CMU-Robotics-Club/QBot/3D Printer Design/MDR-M7 Individual STL/MDR-M7-MotoG.JPG

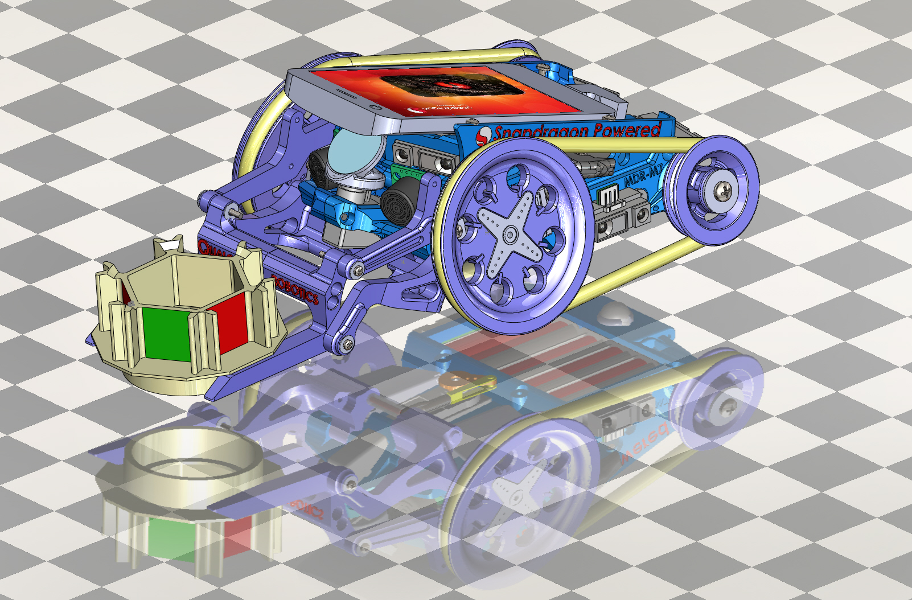
3D Printer Design/MDR-M7 Individual STL/MDR-M7-MotoG.JPG
