CMU-Robotics-Club/QBot/3D Printer Design/MDR-M7 Body STL/MDR-M7-BodyParts.JPG

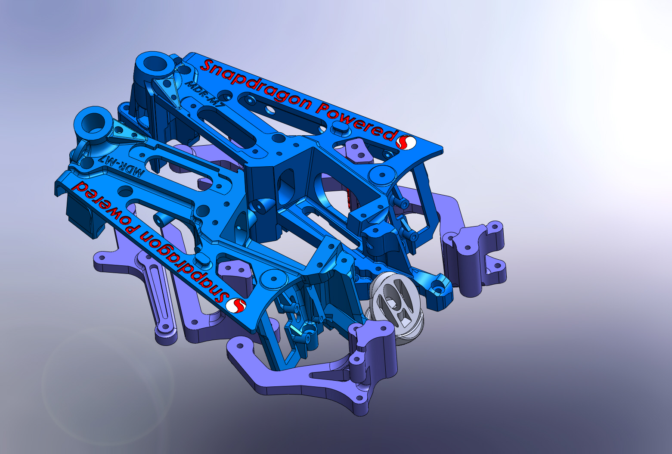
3D Printer Design/MDR-M7 Body STL/MDR-M7-BodyParts.JPG
