CMU-Robotics-Club/QBot/README.md

QBot
====

Experiments with a Qualcomm designed robot platform. 

Documentation https://www.qualcomm.com/invention/research/projects/robotics/micro-rover

Bluetooth Pass: 4545
