CMU-Robotics-Club/QBot/3D Printer Design/QBotBOM.xlsx

 | Snapdragon Bot Bill of Materials | Number of Teams | 6
Received | Part | Quantity | Overall Quantity | Source | Link | Approx Price | Total Price | Notes
yes | 1-INCH DIAMETER MIRROR | 1 | 6 | amazon | http://www.amazon.com/1-IN-ROUND-MIRROR- 25PC-PKG/dp/B0018N66YC (http://www.amazon.com/1-IN-ROUND-MIRROR-%2025PC-PKG/dp/B0018N66YC) | $8.24 | $8.24 | 25 piece set
 | 4-PIN RIGHT ANGLE HEADER, 0.100-INCH SPACINGND/314229 | 1 | 6 | digikey | http://www.digikey.com/product-detail/en/0022288243/WM50026-24-ND/314229 | $1.53 | $9.18
 | 2X4 STRAIGHT HEADER, 0.100-INCH SPACING | 1 | 6 | digikey | http://www.digikey.com/product-search/en?vendor=0&keywords=67997-210HLF | $0.42 | $2.52
 | 2-PIN RIGHT ANGLE HEADER, 0.100-INCH SPACING | 1 | 6 | digikey | http://www.digikey.com/product-search/en?vendor=0&keywords=0901220125 | $1.39 | $8.34
 | IOIO-OTG | 1 | 6 | diygadget | http://www.diygadget.com/ | $25.00 | $150.00 | This package comes with a bluetooth dongle
 | TURNIGY TG9 SERVO | 1 | 6 | hobbyking | http://hobbyking.com/hobbyking/store/__42420__ Turnigy_TG9_9g_1_7kg_0_12sec_Eco_Micro_Servo_ USA_warehouse_.html | $2.60 | $15.60
 | Makerbot Replicator Blue ABS Filament | 2 | 2 | makerbot | https://store.makerbot.com/abs-filament | $48.00 | $96.00 | Get 1 purple and 1 red
 | 112-MM LENGTH, 6-MM DIAMETER O-RING | 2 | 12 | marshallshardware | http://www.marshallshardware.com/products/product.aspx?pid=26886&kw=6112&st=0 | $2.70 | $32.40
 | #10 X 3/4 X 0.040-INCH FLAT NYLON WASHER | 2 | 12 | marshallshardware | http://www.marshallshardware.com/products/product.aspx?pid=11344&kw=NYLON%20washer&st=0 | $0.10 | $1.20
 | M2.5 PAN HEAD MACHINE SCREW, 6-MM LENGTH | 13 | 78 | marshallshardware | http://www.marshallshardware.com/products/product.aspx?pid=2-52-733-158-9497&lid=1 | $0.05 | $3.90
 | #8 X 3/8 X 1-INCH NYLON SPACER | 2 | 12 | marshallshardware | http://www.marshallshardware.com/products/product.aspx?pid=14290&lid=1%20%20%20% 20%20%20%20%20%20%20%20%20%20%20%20%20&kw=0511107&st=0 | $0.19 | $2.28
yes | 2-56 X 7/8-INCH PAN HEAD MACHINE SCREW | 6 | 36 | mcmaster | http://www.mcmaster.com/#91772a085/=sda7o1 | $4.66 | $4.66 | Packs of 100
yes | 2-56 HEX NUT | 6 | 36 | mcmaster | http://www.mcmaster.com/#90760a009/=sjt7h4 | $3.11 | $3.11 | Packs of 100
yes | 4-40 SOCKET HEAD MACHINE SCREW, 1 ½-INCH LENGTH | 2 | 12 | mcmaster | http://www.mcmaster.com/#91251a149/=sd9q3y | $11.48 | $11.48 | Packs of 50
yes | #8 3/8-INCH FLAT NYLON SPACER, LENGTH 1 1/8-INCH LENGTH | 2 | 12 | mcmaster | http://www.mcmaster.com/#94639a068/=sjs9om | $7.33 | $21.99 | Packs of 5
yes | MUSIC WIRE, 0.078-INCH DIAMETER, 1.40-INCH LENGTH | 1 | 1 | mcmaster | http://www.mcmaster.com/#8890k122/=su430w | $2.17 | $2.17 | 3 foot rod
yes | 4-40 NYLON SCREW, ½-INCH LENGTH | 4 | 24 | mcmaster | http://www.mcmaster.com/#93135a276/=sjtpg7 | $5.25 | $5.25 | Pack of 100
yes | #2 FLAT WASHER | 10 | 60 | mcmaster | http://www.mcmaster.com/#90126a501/=sda9xs | $1.48 | $1.48 | Pack of 100
yes | 4-40 SOCKET HEAD MACHINE SCREW, 1-INCH LENGTH | 2 | 12 | mcmaster | http://www.mcmaster.com/#91251a115/=sd9pat | $5.31 | $5.31 | Pack of 50
yes | 8-32 PAN HEAD MACHINE SCREW, 1.625-INCH LENGTH | 2 | 12 | mcmaster | http://www.mcmaster.com/#91772a204/=sjs8kq | $7.68 | $7.68 | Pack of 50
yes | 18-8 THREAD FORMING SCREW, 1-32 THREAD, ¼-INCH LENGTH | 8 | 48 | mcmaster | http://www.mcmaster.com/#99461a615/=sjtall | $11.45 | $11.45 | Pack of 50
yes | 4-40 FLAT HEAD MACHINE SCREW, ¾-INCH LENGTH | 1 | 6 | mcmaster | http://www.mcmaster.com/#91771a113/=ske8x2 | $5.42 | $5.42 | Pack of 100
 | Moto G | 1 | 6 | new egg | http://www.newegg.com/Product/Product.aspx?Item=N82E16875209391 | $100.00 | $600.00 | Galexy S3/S4 works too
 | AR-3606HB ROBOT SERVO | 2 | 12 | pololu | http://www.pololu.com/product/2149/pictures | $15.00 | $180.00
 | HD-3001HB ANALOG SERVO | 1 | 6 | pololu | http://www.pololu.com/product/1058 | $10.00 | $60.00
 | 2-BATTERY BAY | 1 | 6 | pololu | http://www.pololu.com/product/1150 | $0.70 | $4.20
 | 3-PIN TOGGLE SWITCH | 1 | 6 | pololu | http://www.pololu.com/product/1407 | $1.75 | $10.50
 | 3-BATTERY BAY | 1 | 6 | pololu | http://www.pololu.com/product/142 | $1.00 | $6.00
 |  |  |  |  |  |  | $1270.36
