CMU-Robotics-Club/QBot/3D Printer Design/MDR-M7 Wheels STL/MDR-M7-WheelParts.JPG

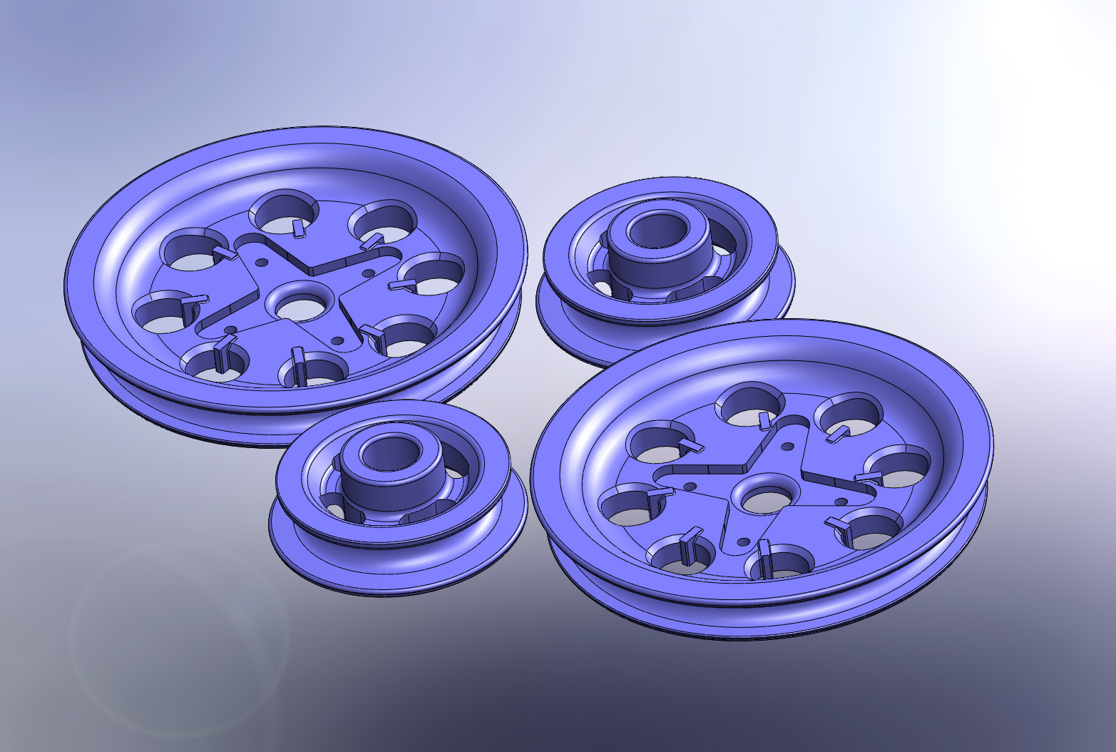
3D Printer Design/MDR-M7 Wheels STL/MDR-M7-WheelParts.JPG
