CMU-Robotics-Club/QBot/3D Printer Design/MDR-M7 CAD IGES/IFC6410CamMnt7.IGS

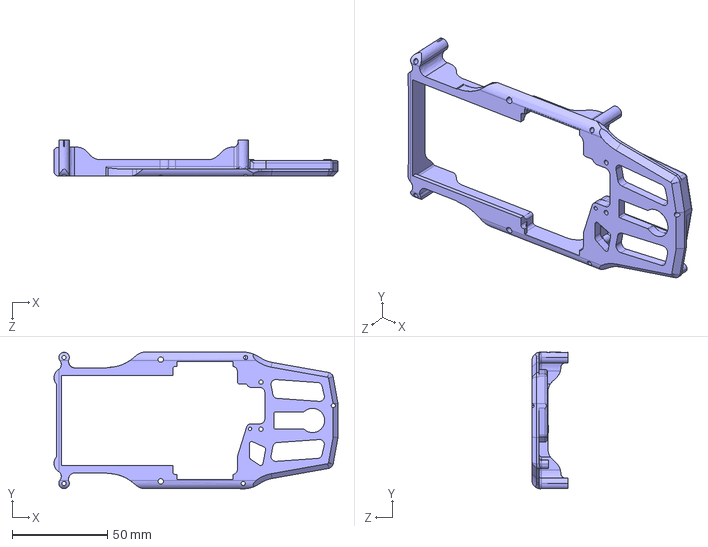
[picture p4: CAD file, 2014-09-16]
3D Printer Design/MDR-M7 CAD IGES/IFC6410CamMnt7.IGS
149.1 x 71.7 x 19.1 mm
