CMU-Robotics-Club/QBot/3D Printer Design/MDR-M7 Individual STL/MDR-M7-WheelParts - MDR-FrontWheel-1.STL

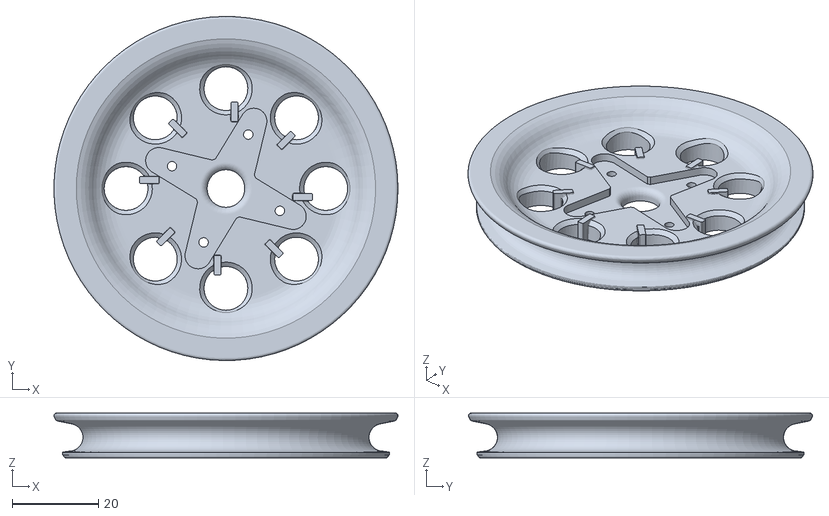
[picture p5: CAD file, 2014-09-16]
3D Printer Design/MDR-M7 Individual STL/MDR-M7-WheelParts - MDR-FrontWheel-1.STL
79.8 x 79.8 x 10.4
