CMU-Robotics-Club/QBot/3D Printer Design/MDR-M7 Individual STL/MDR-M7-BodyParts - MDR-RightUpperForkLiftArm-1.STL

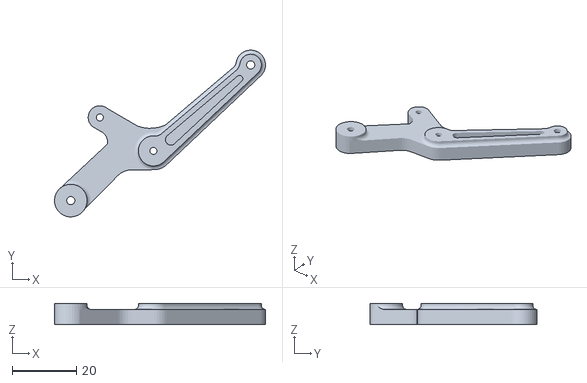
[picture p6: CAD file, 2014-09-16]
3D Printer Design/MDR-M7 Individual STL/MDR-M7-BodyParts - MDR-RightUpperForkLiftArm-1.STL
65.5 x 51.7 x 6.67
