CMU-Robotics-Club/QBot/3D Printer Design/MDR-M7 Individual STL/MDR-M7-BodyParts - MDR-RightForkLift-1.STL

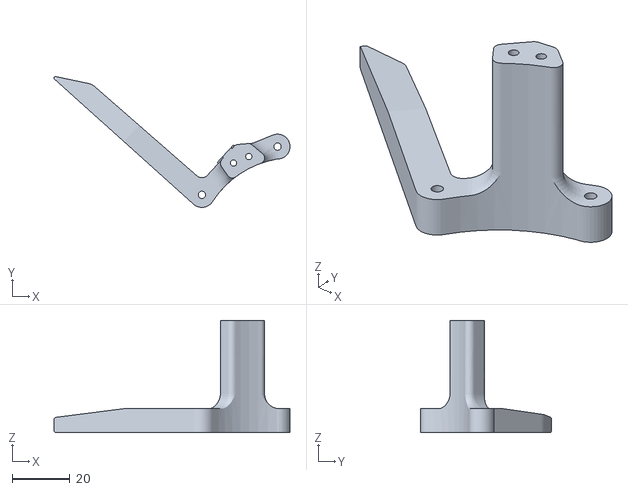
[picture p7: CAD file, 2014-09-16]
3D Printer Design/MDR-M7 Individual STL/MDR-M7-BodyParts - MDR-RightForkLift-1.STL
81.5 x 45.2 x 38.7
