CMU-Robotics-Club/QBot/3D Printer Design/MDR-M7 Individual STL/MDR-M7-BodyParts - MDR-MirrorMount-1.STL

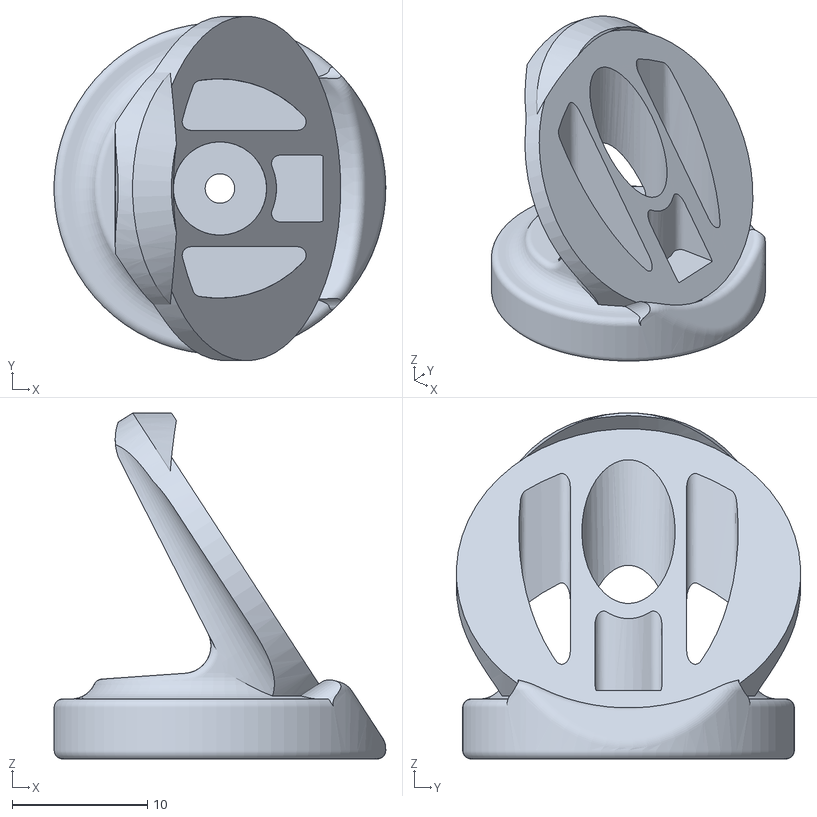
[picture p8: CAD file, 2014-09-16]
3D Printer Design/MDR-M7 Individual STL/MDR-M7-BodyParts - MDR-MirrorMount-1.STL
24.6 x 25.5 x 25.6
