CMU-Robotics-Club/QBot/3D Printer Design/MDR-M7 Individual STL/MDR-M7-BodyParts - MDR-Right-Frame-1.STL

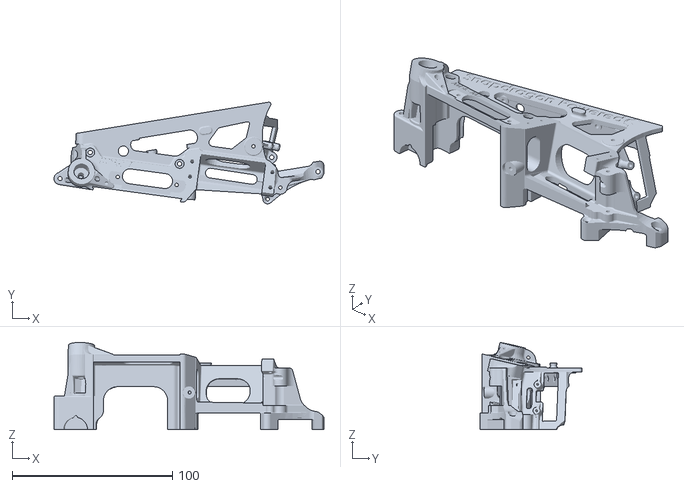
[picture p9: CAD file, 2014-09-16]
3D Printer Design/MDR-M7 Individual STL/MDR-M7-BodyParts - MDR-Right-Frame-1.STL
168.5 x 63.5 x 54.4
