CMU-Robotics-Club/QBot/3D Printer Design/MDR-M7 Individual STL/MDR-M7-WheelParts - MDR-BackWheel-4.STL

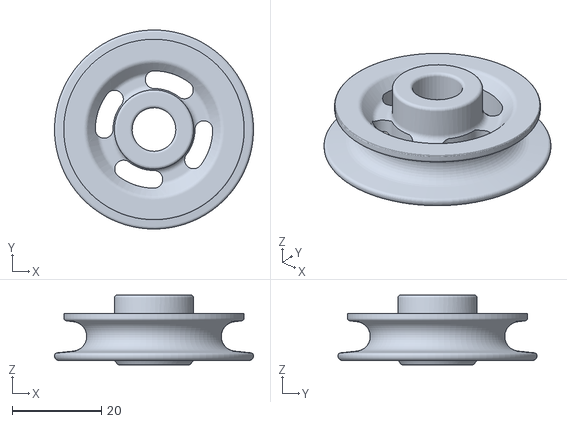
[picture p10: CAD file, 2014-09-16]
3D Printer Design/MDR-M7 Individual STL/MDR-M7-WheelParts - MDR-BackWheel-4.STL
44.6 x 44.6 x 15.7
