CMU-Robotics-Club/QBot/3D Printer Design/MDR-M7 Individual STL/MDR-M7-BodyParts - MDR-RightLowerForkLiftArm-1.STL

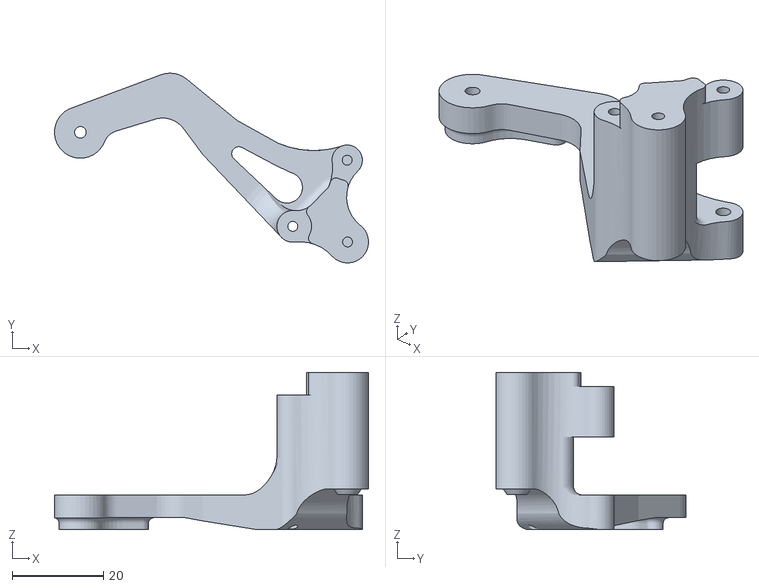
[picture p11: CAD file, 2014-09-16]
3D Printer Design/MDR-M7 Individual STL/MDR-M7-BodyParts - MDR-RightLowerForkLiftArm-1.STL
68.9 x 41.6 x 34.5
