CMU-Robotics-Club/QBot/3D Printer Design/MDR-M7 Individual STL/MDR-CrateSm.STL

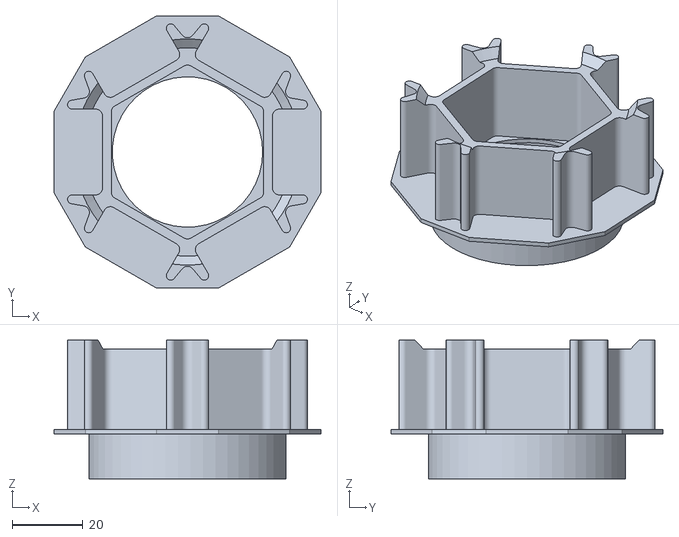
[picture p12: CAD file, 2014-09-16]
3D Printer Design/MDR-M7 Individual STL/MDR-CrateSm.STL
75.6 x 77.1 x 39.4
