CMU-Robotics-Club/QBot/(list of files, cad)

Other CAD files:
3D Printer Design/MDR-M7 Individual STL/MDR-M7-WheelParts - MDR-FrontWheel-2.STL
3D Printer Design/MDR-M7 Individual STL/MDR-M7-WheelParts - MDR-BackWheel-3.STL
3D Printer Design/MDR-M7 Individual STL/IFC6410CamMnt7.STL
3D Printer Design/MDR-M7 Individual STL/MDR-M7-BodyParts - MDR-LeftLowerForkLiftArm-2.STL
3D Printer Design/MDR-M7 Individual STL/MDR-M7-BodyParts - MDR-LeftUpperForkLiftArm-1.STL
