CMU-Robotics-Club/QBot/(commit log)

2014-09-16 Added all solidworks files and BOM
    [IFC6410CamMnt7.IGS, IFC6410CamMnt7.STL, MDR-CrateSm.STL, MDR-M7-BodyParts - MDR-Left-Frame-1.STL, MDR-M7-BodyParts - MDR-LeftForkLift-1.STL, MDR-M7-BodyParts - MDR-LeftLowerForkLiftArm-2.STL, MDR-M7-BodyParts - MDR-LeftUpperForkLiftArm-1.STL, MDR-M7-BodyParts - MDR-MirrorMount-1.STL]
2014-10-08 Added BOM (excel)
    [QBotBOM.xlsx]
